hackaninstant/Servo-Shutter/Leaf Shutter.jpg

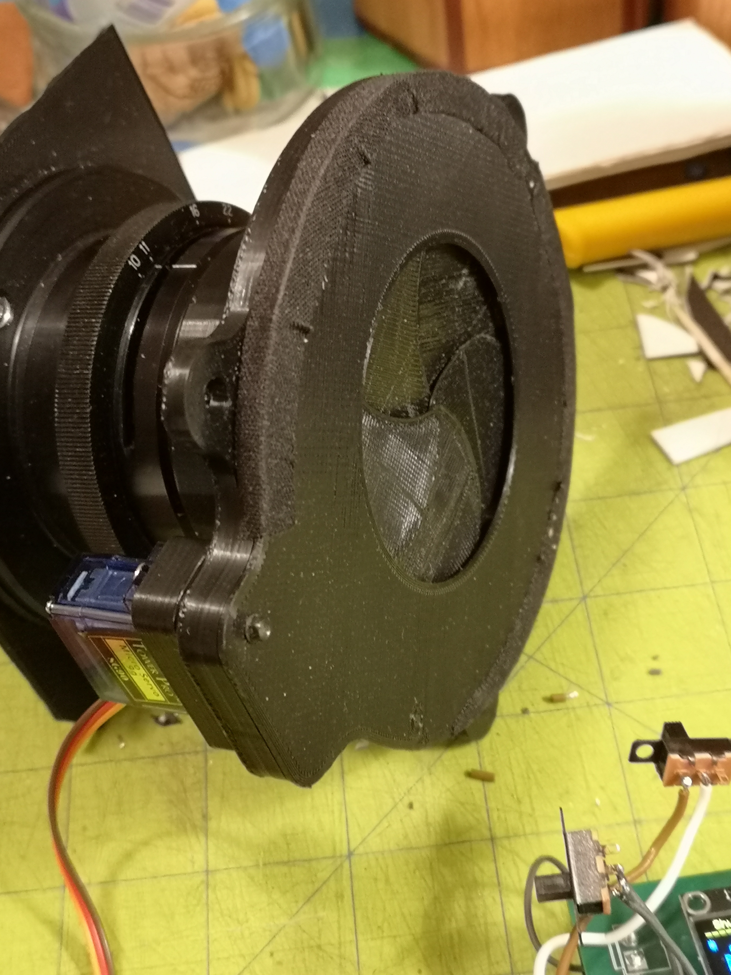
Leaf Shutter.jpg
