hackaninstant/Servo-Shutter/PCB board.jpg

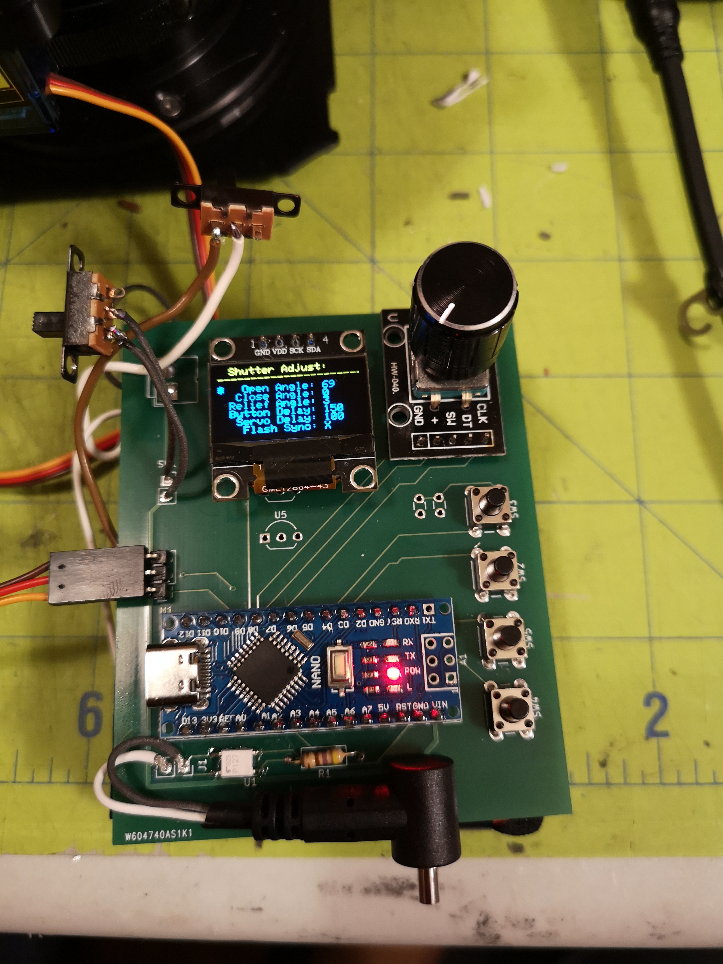
PCB board.jpg
