hackaninstant/Servo-Shutter/Schematic.jpg

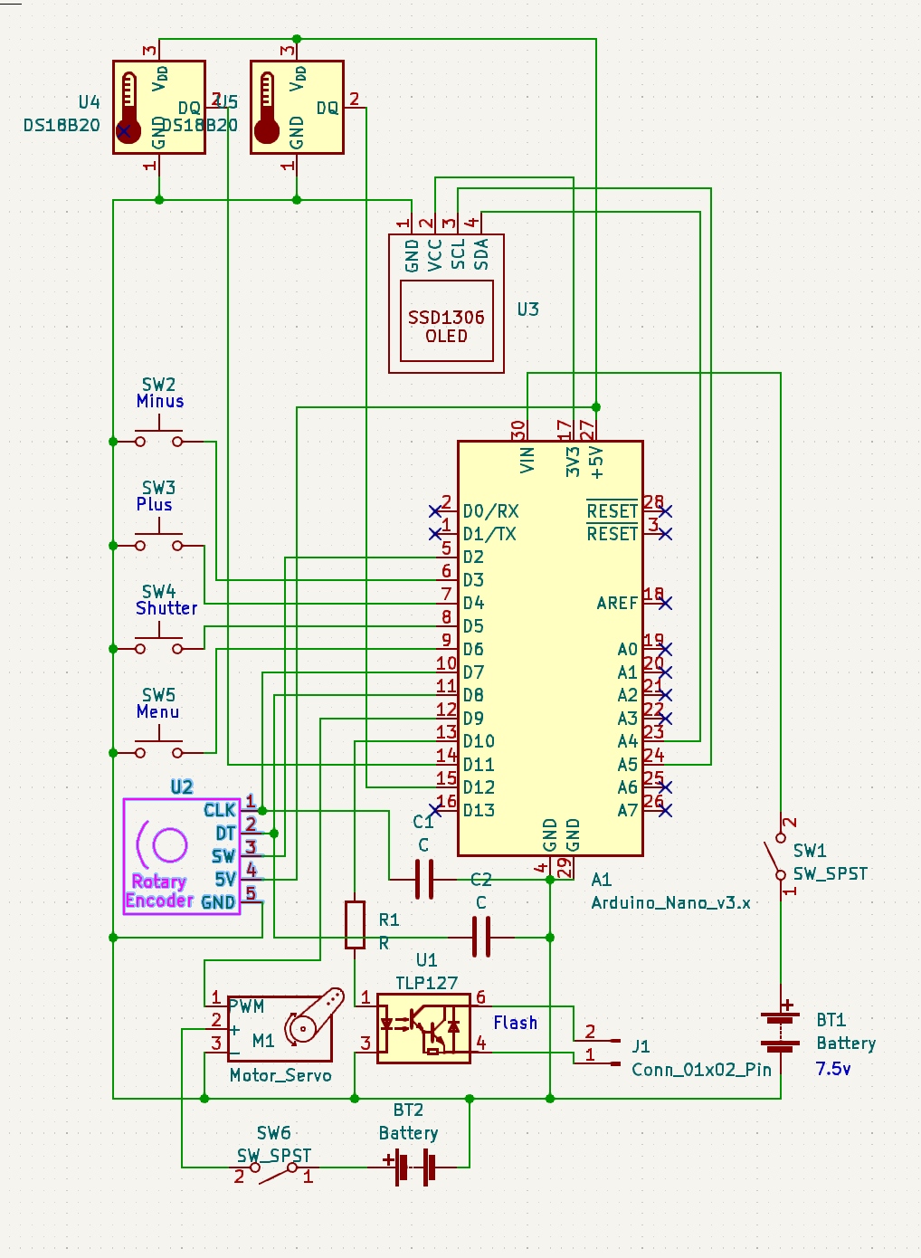
Schematic.jpg
