hackaninstant/Servo-Shutter/Servo shutter.jpg

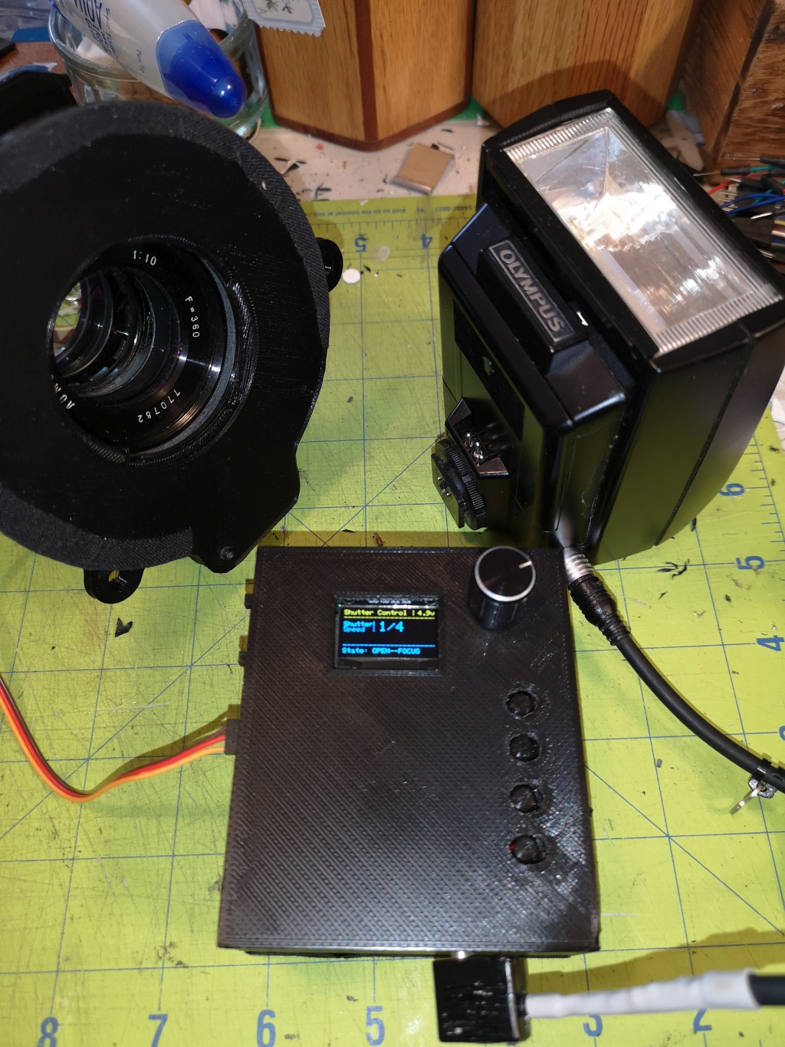
Servo shutter.jpg
