hackaninstant/Servo-Shutter/(threads)

Thread 1 (2024-06-25):

Should batteries negative's be linked to the GND PIN or not ?

fitaine, 2024-06-25:
Hi,
I downloaded the gerber file and ordered a pcb but I have a hard time knowing what to do. I don't want to make mistake as it could be dangerous.

My wondering is why isn't there any connection to both of the negatives of the batteries ? Positives are linked to the VIN pin. **Should negatives be linked to the GND PIN or not ?**

-

Also, to make my future device rechargeable by mini USB I bought two TP4506 to place between lipo batteries and the PCB. I'll adjust the voltage for the servo with a mini DC/DC voltage regulator. I'll try to hook all stuff on one battery, see if it works, because it annoys me to have to recharge nano and servo separately. I'll keep you noted !

Closed 2024-08-17.
