hackaninstant/Servo-Shutter/(commit log)

2023-07-03 Added rotary encoder support
2023-07-04 Servo Shutter schematic
2023-07-13 Schematic diagram
2023-07-13 PCB board gerber files
2023-07-15 3d STL files for printing
